ricknoboa137/OE_NPK_IoT_sensor/tests/2026-10-27_good_soil/readings.csv

timestamp | humidity | temperature | PH | N | P | K
1793103829 | 27.3 | 18.7 | 6.3 | 1.0 | 48.0 | 41.0
1793103834 | 33.0 | 18.7 | 6.4 | 3.0 | 53.0 | 45.0
1793103839 | 31.7 | 18.8 | 6.4 | 7.0 | 63.0 | 55.0
1793103844 | 31.0 | 18.8 | 6.5 | 7.0 | 62.0 | 54.0
1793103849 | 31.6 | 18.8 | 6.4 | 7.0 | 62.0 | 54.0
1793103854 | 35.0 | 18.8 | 6.4 | 7.0 | 62.0 | 55.0
1793103859 | 28.0 | 18.9 | 6.4 | 7.0 | 63.0 | 55.0
1793103864 | 32.7 | 18.9 | 6.4 | 7.0 | 62.0 | 55.0
1793103869 | 28.2 | 18.9 | 6.4 | 7.0 | 62.0 | 55.0
1793103874 | 33.2 | 18.9 | 6.5 | 7.0 | 63.0 | 56.0
1793103879 | 28.1 | 18.9 | 6.5 | 7.0 | 64.0 | 56.0
1793103884 | 27.8 | 19.0 | 6.5 | 8.0 | 64.0 | 57.0
1793103889 | 27.7 | 19.0 | 6.5 | 8.0 | 65.0 | 57.0
1793103894 | 28.0 | 19.0 | 6.5 | 9.0 | 68.0 | 60.0
1793103899 | 32.8 | 19.0 | 6.5 | 12.0 | 75.0 | 67.0
1793103904 | 32.7 | 19.0 | 6.5 | 11.0 | 72.0 | 64.0
1793103909 | 33.4 | 19.0 | 6.5 | 10.0 | 70.0 | 63.0
1793103914 | 33.0 | 19.0 | 6.5 | 10.0 | 71.0 | 63.0
1793103919 | 32.1 | 19.0 | 6.5 | 11.0 | 71.0 | 64.0
1793103924 | 29.0 | 19.1 | 6.5 | 11.0 | 71.0 | 64.0
1793103929 | 28.2 | 19.0 | 6.5 | 11.0 | 71.0 | 64.0
1793103934 | 32.1 | 19.1 | 6.5 | 11.0 | 72.0 | 64.0
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
