ricknoboa137/OE_NPK_IoT_sensor/tests/2026-10-25_weak_soil/readings.csv

timestamp | humidity | temperature | PH | N | P | K
1792950630 | 29.4 | 17.5 | 7.6 | 2.0 | 52.0 | 44.0
1792950635 | 28.0 | 17.5 | 7.5 | 6.0 | 61.0 | 53.0
1792950640 | 28.0 | 17.5 | 7.4 | 7.0 | 63.0 | 55.0
1792950645 | 32.6 | 17.6 | 7.2 | 8.0 | 64.0 | 57.0
1792950650 | 27.4 | 17.7 | 7.0 | 8.0 | 65.0 | 58.0
1792950655 | 30.4 | 17.9 | 6.9 | 8.0 | 66.0 | 59.0
1792950660 | 29.3 | 18.0 | 6.8 | 9.0 | 68.0 | 60.0
1792950665 | 27.6 | 18.1 | 6.7 | 9.0 | 68.0 | 61.0
1792950670 | 27.7 | 18.2 | 6.6 | 10.0 | 69.0 | 62.0
1792950675 | 29.8 | 18.3 | 6.6 | 10.0 | 70.0 | 63.0
1792950680 | 29.8 | 18.5 | 6.5 | 11.0 | 71.0 | 64.0
1792950685 | 28.1 | 18.6 | 6.5 | 11.0 | 72.0 | 64.0
1792950690 | 31.6 | 18.7 | 6.4 | 11.0 | 73.0 | 65.0
1792950695 | 29.3 | 18.8 | 6.4 | 12.0 | 74.0 | 66.0
1792950700 | 27.4 | 18.8 | 6.3 | 12.0 | 74.0 | 67.0
1792950705 | 27.7 | 19.0 | 6.3 | 12.0 | 75.0 | 67.0
1792950710 | 27.6 | 19.0 | 6.3 | 13.0 | 76.0 | 68.0
1792950715 | 27.9 | 19.1 | 6.2 | 13.0 | 76.0 | 69.0
1792950720 | 27.4 | 19.2 | 6.2 | 13.0 | 76.0 | 69.0
1792950725 | 27.9 | 19.3 | 6.2 | 13.0 | 77.0 | 69.0
1792950730 | 29.9 | 19.3 | 6.2 | 13.0 | 77.0 | 70.0
1792950735 | 27.8 | 19.4 | 6.1 | 13.0 | 78.0 | 70.0
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
