ricknoboa137/OE_NPK_IoT_sensor/tests/2026-10-25_weak_soil/weak_soil_test.png

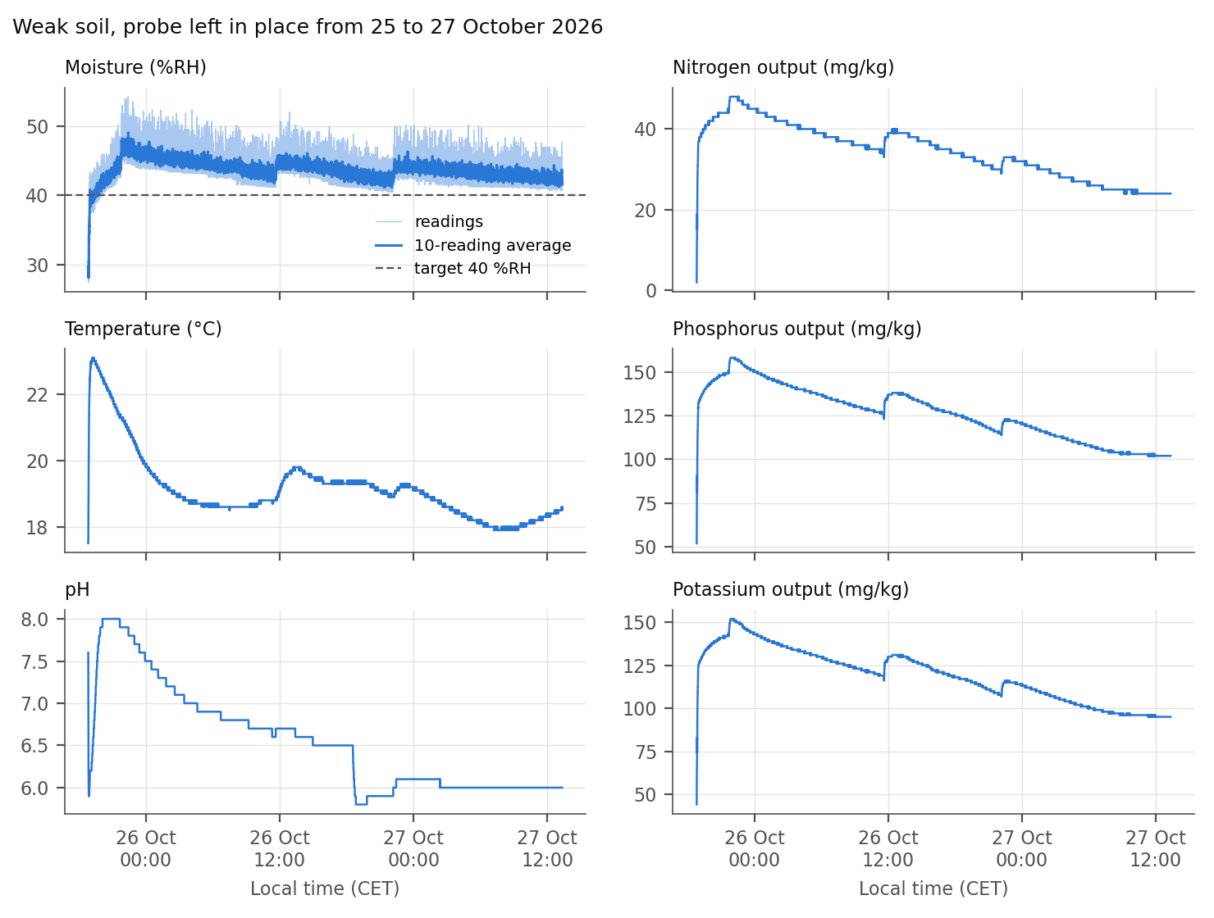
tests/2026-10-25_weak_soil/weak_soil_test.png
