ricknoboa137/OE_NPK_IoT_sensor/tests/2026-10-27_good_soil/good_soil_test.png

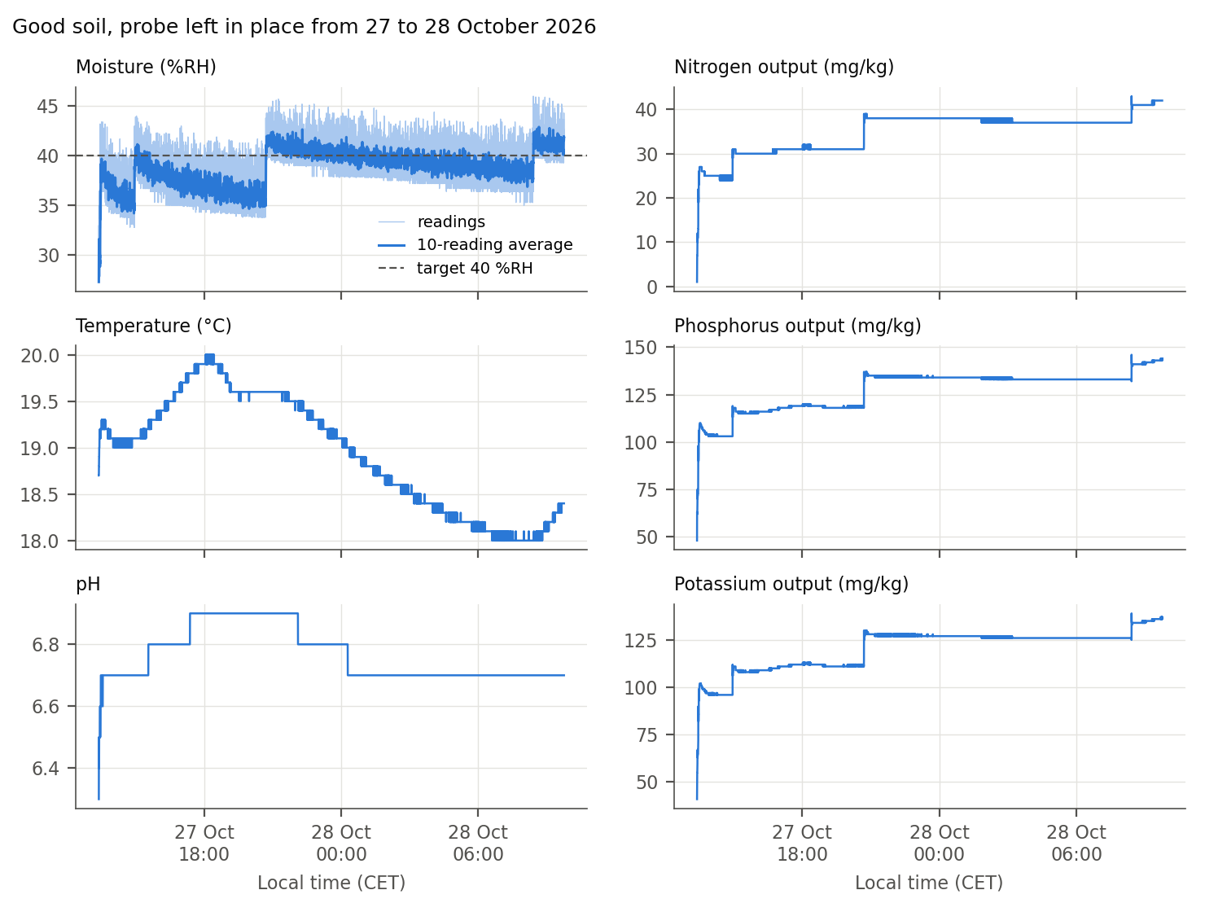
tests/2026-10-27_good_soil/good_soil_test.png
