ricknoboa137/OE_NPK_IoT_sensor/tests/2026-10_two_soil_calibration/two_soil_comparison.png

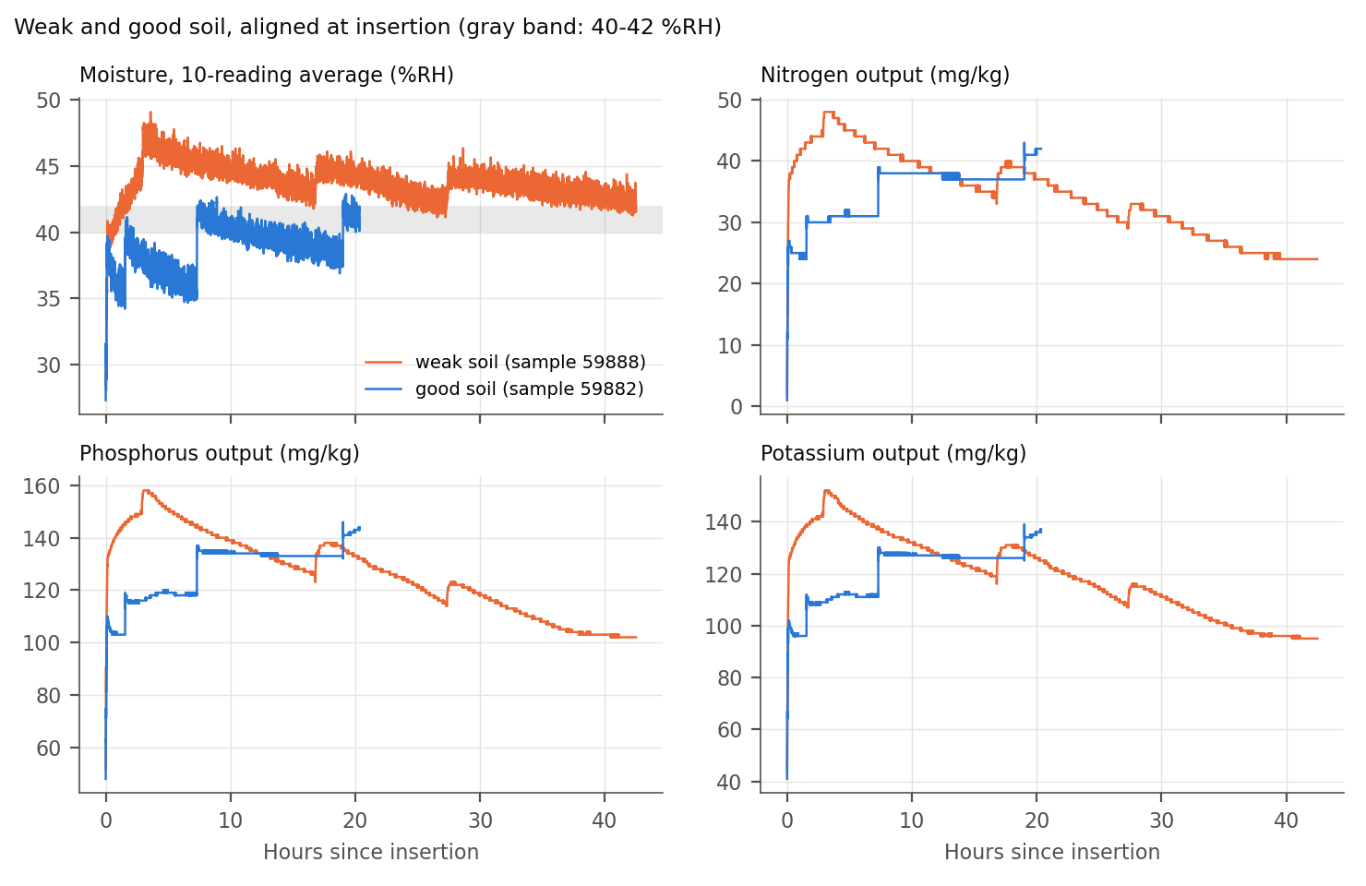
tests/2026-10_two_soil_calibration/two_soil_comparison.png
