ricknoboa137/OE_NPK_IoT_sensor/firmware/SoilNode/NpkNet.h

/*
 * NpkNet.h - WiFi provisioning and the MQTT link.
 *
 * Deliberately NOT called NetworkManager: arduino-esp32 3.x declares a class
 * of that name in libraries/Network/src/NetworkManager.h, which WiFi.h pulls
 * in transitively, and the two collide.
 *
 * Differences from the original sketch that matter in the field:
 *
 *  - The broker address and port entered in the captive portal are written to
 *    NVS and reloaded at boot. Previously they were captured into RAM after
 *    setServer() had already been called with the compile-time defaults, so
 *    the portal fields never took effect.
 *  - A broker outage no longer erases the WiFi credentials. The original
 *    reconnect() called wm.resetSettings() after five failed MQTT attempts,
 *    which meant a broker reboot could strand the node in AP mode.
 *  - Reconnection is non-blocking with backoff, so sampling continues while
 *    the broker is unreachable.
 */
#ifndef NPK_NET_H
#define NPK_NET_H

#include <Arduino.h>

class NpkNet {
 public:
  typedef void (*MessageHandler)(char* topic, uint8_t* payload, unsigned int length);

  // forcePortal opens the configuration portal even when stored credentials
  // would have connected, so the broker fields can be changed in the field.
  bool begin(MessageHandler handler, bool forcePortal = false);

  // Pumps the MQTT client and retries the connection when it is down.
  // Never blocks for longer than one connection attempt.
  void loop();

  bool connected();
  bool publish(const char* topic, const char* payload, bool retain = false);

  const char* host() const { return host_; }
  uint16_t    port() const { return port_; }
  const char* clientId() const { return clientId_; }

  const char* user() const { return user_; }
  bool hasAuth() const { return user_[0] != 0; }

  // Store a new broker and drop the current connection so loop() picks it up.
  bool setBroker(const char* host, uint16_t port);

  // Broker credentials. Pass empty strings for an anonymous broker.
  bool setAuth(const char* user, const char* pass);

  void startPortal();   // open the config portal on demand
  void forgetWiFi();    // clear stored credentials, then reboot

  void printStatus(Print& out);

 private:
  bool connectBroker();
  void loadSettings();

  char     host_[40] = { 0 };
  uint16_t port_ = 1883;
  char     user_[33] = { 0 };
  char     pass_[65] = { 0 };
  char     clientId_[24] = { 0 };
  uint32_t nextAttempt_ = 0;
  uint32_t backoff_ = 0;
};

#endif // NPK_NET_H
