ricknoboa137/OE_NPK_IoT_sensor/(commit log)

2026-04-01 Update IoT_NPK_sensor.ino
    Updated NPK sensor Code, JSon structure added
2026-08-23 Restructure firmware into modules and add per-channel calibration
    The sketch was a single file in which the Modbus layer, the WiFi
    provisioning, the MQTT client and the payload assembly were interleaved.
    Split it into modules and fix the defects that showed up while doing so.
    The original is kept at firmware/original/IoT_NPK_sensor.ino.
    Structure (firmware/NPK_Sensor/):
    Config.h all tunables
    Channels.* the seven quantities, units and scale factors
    SoilSensor.* Modbus RTU master: CRC, turnaround, retries, map
    Calibration.* A and B per channel, persisted in NVS
    NetworkManager.* WiFiManager provisioning and the MQTT link
    CommandHandler.* console shared by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
    [Calibration.h, CommandHandler.cpp, IoT_NPK_sensor.ino, JsonCompat.h, NPK_Sensor.ino, NetworkManager.cpp, NetworkManager.h]
2026-08-23 Rename NetworkManager to NetLink to fix a clash with the ESP32 core
    arduino-esp32 3.x ships its own NetworkManager class in
    libraries/Network/src/NetworkManager.h, which WiFi.h pulls in
    transitively, so building against core 3.2.1 failed with:
    error: redefinition of 'class NetworkManager'
    Both the class and the header basename collided. Renamed to NetLink and
    noted in the header why, so it does not get renamed back.
    Checked the rest of the sketch against the 3.2.1 tree while here: no other
    header basename or type name in this firmware collides with anything the
    core declares.
    [CommandHandler.cpp, NPK_Sensor.ino, NetLink.cpp, NetLink.h]
2026-08-23 moved original code to subfolder for arduino copiler
2026-08-23 Rebuild the firmware as SoilNode with an Npk prefix on every name
    Replaces firmware/NPK_Sensor/ with firmware/SoilNode/. Same design and
    same verified logic; new folder, new filenames, new type names.
    Two reasons for the move:
    1. arduino-esp32 3.x declares class NetworkManager in
    libraries/Network/src/NetworkManager.h, which WiFi.h pulls in. The
    previous revision collided with it. Renaming one class fixed that
    instance but left the general hazard. Every file and type is now
    prefixed Npk, checked against the 3.2.1 tree: nothing collides.
    2. Arduino leaves stale copies of renamed sketch files in its build
    folder and keeps compiling them (arduino-cli#1699), so the earlier
    N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
    [NpkCal.cpp, NpkCal.h, NpkConfig.h, NpkConsole.cpp, NpkConsole.h, NpkJson.h, NpkNet.cpp, NpkNet.h]
2026-08-23 Add MQTT credentials to the portal and a way to reopen it
    Reported: the configuration AP never appears. That is autoConnect() doing
    what it does - it only raises the AP when the stored credentials fail, and
    WiFi credentials saved by the previous sketch live in the NVS partition and
    survive reflashing, so the node joins silently. Working as intended, but
    with no way back in once it does. Three routes added:
    - hold BOOT during the first three seconds of boot (NPK_PORTAL_BTN_*).
    Sampled after startup, not through reset, since GPIO0 low at reset means
    download mode.
    - "wifi portal" on the console, without dropping the WiFi connection.
    - "wifi reset", unchanged.
    The portal was also missing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
    [NpkConfig.h, NpkConsole.cpp, NpkNet.cpp, NpkNet.h, NpkSensor.cpp, SoilNode.ino]
2026-08-23 Default to the contiguous register map and reject impossible readings
    Reported values were 152.4 %RH, 151.7 degC and 4090 mg/kg N with ok:true -
    every CRC valid, every number wrong.
    This probe is the contiguous-block variant, not the one the manual
    describes. Evidence, from the 83,883 rows the original firmware logged into
    DB_01.db reading 0x0000-0x0006 with everything scaled by 0.1:
    humidity 0 - 75.9 % (range 0-100)
    temperature 17.7 - 29.9 degC
    pH 3.9 - 9.0 (datasheet spec is 3-9 pH)
    N/P/K 0 - 44.6 mg/kg (range 0-1999)
    All physically sensible, and the pH range in particular is not something a
    wrong scale lands on by accident. The bad rea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
    [NpkConfig.h, NpkConsole.cpp, NpkSensor.cpp, NpkSensor.h]
2026-08-23 Retarget the firmware at the VMS-3001-TR, the sensor actually in use
    The probe is a VMS-3001-TR-*-N01 (Weimengshi five-pin soil transmitter), not
    the JXBS-3001 this project started from. Its manual is included, and unlike
    the JXBS one it is internally consistent - both example CRCs verify and every
    worked example decodes to the value it claims.
    Register map, manual section 5.3, confirmed by the worked example in 5.4:
    0x0000 moisture value x10 -> /10
    0x0001 temperature value x10 -> /10, signed
    0x0002 conductivity whole us/cm, NOT scaled
    0x0003 pH value x10 -> /10
    0x0007 salinity, 0x0008 TDS (documented, not read)
    0x0050-0x0053 on-sensor calibration offs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
2026-08-23 Retarget at the CWT NPK 5-pin probe and fix the N/P/K scaling
    The correct manual is "NPK type (5Pin probe) manual V1.4" from Shenzhen
    ComWinTop, now included in firmware/SoilNode/. The two earlier manuals this
    project was worked against - JXBS-3001 and VMS-3001-TR - described different
    sensors and are discarded.
    Unlike either of those, this manual is trustworthy: all nine of its example
    frames CRC-check correctly and every worked example decodes to the value it
    claims.
    Register map (manual page 3), function 0x03:
    0x0000 humidity 0.1 %RH /10
    0x0001 temperature 0.1 degC /10, signed
    0x0002 conductivity 1 us/cm /1
    0x0003 pH 0.1 /10
    0x0004 nitrogen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
    [NpkConfig.h, NpkConsole.cpp, NpkConsole.h, NpkSensor.cpp, NpkSensor.h]
2026-08-23 Publish conductivity again, documenting that this unit always reads 0
    Register 0x0002 is slot 2 of the block already being read, so decoding and
    publishing it costs nothing. This probe reports a constant 0 because it does
    not measure conductivity - the register answers with a valid CRC, so zero is
    the correct reading rather than a fault.
    Zero is inside the 0-20000 us/cm range, so the range check passes it and "ok"
    stays true. Documented in both READMEs and in the header comments, since a
    permanently flat channel otherwise looks like a bug.
    NPK_ENABLE_CONDUCTIVITY still drops it from the payload if the constant is
    not wanted; verified that the enum, channel table and slot map stay
    consisten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
    [NpkConfig.h, NpkSensor.h]
2026-08-23 Validate calibration coefficients at every boundary they cross
    Asked how the A and B values are validated. Auditing it turned up three
    gaps, all now closed.
    1. Nothing validated the factors read back from the probe. readFloat()
    reinterpreted two raw registers as a float and returned it, so an
    unimplemented or never-written register decoded to NaN, an infinity or a
    denormal and "sensor" printed it as a gain. It now rejects non-finite and
    denormal values with a reason.
    2. The range check ran on the raw reading only, before calibration. A
    mistyped coefficient turned a valid 46.4 %RH into 46400 and published it
    with ok:true. The calibrated result is now checked against the sa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
2026-08-23 Read back the three registers that have documented factory defaults
    The "sensor" command read the offset registers and the N/P/K factor floats
    but skipped 0x0022-0x0024, which are the only calibration registers the
    manual gives factory values for: conductivity factor 0, salinity factor 55,
    TDS factor 50.
    Those are worth having for two reasons. They answer "what did this unit ship
    with", which the other registers cannot since the manual documents no
    defaults for them. And they are a free end-to-end check - if 0x0023 reads 55
    and 0x0024 reads 50, addressing, framing and decoding are all confirmed
    against known-good values, which is useful given nothing on the write path
    has been exercised aga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
    [NpkConsole.cpp]
2026-08-23 Fix two string literals broken by a raw newline, and add a checker
    Both sites lost their escape and ended up with a real newline inside the
    literal:
    out.printf("error: %s
    ", why);
    That is my error, introduced while editing, and it made the previous commit
    fail to compile. Repaired to \r\n, matching every other format string here.
    Adds test/check_sources.py so this cannot ship again. It catches, without a
    toolchain: unterminated string literals, unbalanced brackets, printf
    argument counts against the format string, unresolved local includes,
    methods declared but never defined, and NUL bytes. Confirmed against the
    real fault - reintroducing the broken literal makes it report
    NpkConsole.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
    [NpkConsole.cpp]
2026-08-23 Solve the probe's own A and B from standards and write them back
    The probe already holds a gain and an offset per nutrient. Reading and
    writing them individually was supported; what was missing is the step in
    between - working out what they should be.
    "sensor cal <n|p|k> low <ref>" then "... high <ref>" reads the pair the
    probe currently holds, measures against two standards, and composes a
    correction on top rather than overwriting blindly:
    g = (r2 - r1) / (y2 - y1)
    A' = A * g
    B' = r1 - g * (y1 - B)
    The probe's internal value never appears in that, so its internal scaling
    does not need to be known, and the result is identical whatever the starting
    coefficients were - verified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
    [NpkConsole.cpp]
2026-08-23 Size the MQTT reply buffer for the sensor dump, and never truncate silently
    Checking how to invoke the coefficient read turned up that its own reply does
    not fit. The "sensor" dump is around 900 bytes once every register has been
    read back, against a 704-byte reply buffer, and NpkBufferPrint discarded the
    overflow without a word - so over MQTT the answer arrived cut in half looking
    like the whole thing.
    - NPK_MQTT_BUFFER 768 -> 1280, giving a 1216-byte reply allowance.
    - NpkBufferPrint tracks overflow, and handleMqtt publishes an explicit
    truncation notice after the partial reply instead of pretending it is
    complete. The serial copy was never truncated and still is not.
    - The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
    [NpkConfig.h, NpkConsole.cpp, NpkConsole.h, SoilNode.ino]
2026-08-23 Document that sensor commands do work over MQTT, both forms
    The README claimed they had no JSON form. Any unrecognised cmd is passed
    through to the parser verbatim, so {"cmd":"sensor cal n low 50"} reaches the
    same place as the plain-text line. Both are now shown.
2026-08-24 Chunk long MQTT replies, add cal export/json, and a filtered scan
    Console replies no longer truncate over MQTT, and the calibration held in NVS
    can now be backed up and read by machine.
    Replies (task 1). Raising the buffer cannot fix this: "scan" output is
    unbounded and this probe answers at all 65536 addresses, so a full sweep is
    over half a megabyte. Output now streams through NpkChunkedPrint, published
    across as many NPKreply messages as it takes with constant RAM. Splits happen
    only at line boundaries, so no register line is ever cut. Every part except
    the last ends with a line reading exactly "[continues]"; a reply that fits in
    one message carries no marker, so short replies are byte-i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
    [NpkConsole.cpp, NpkConsole.h, NpkSensor.cpp, NpkSensor.h]
2026-09-05 Add Node-RED flows, original database, and tools
2026-09-06 Warn on the two ways a two-soil NPK fit goes wrong silently
    Calibrating N, P and K today from two lab-assayed soils. Both failure modes
    here are invisible after the fact, because a two-point fit passes through
    both points exactly whichever values it was given.
    Negative gain. If the two references are entered against the wrong samples
    the fit is still perfect, just backwards. "cal high" now warns, matching what
    "sensor cal" and solve_firmware_cal.js already did - the firmware-side path
    was the one being used today and was the one without the warning.
    Negative B. B is what a channel reports when the probe reads zero. If it is
    negative, a bottomed-out reading becomes a negative concentration,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
    [NpkConsole.cpp]
2026-09-06 Pool captures by label prefix and report placement uncertainty
    Calibrating N/P/K today from two lab-assayed soils. The plan was 20 readings
    per soil, averaged. Twenty readings from one insertion measure sensor noise,
    which on this probe is nearly zero - the last captures gave N=45 seven times
    with no variation at all. What they do not measure is the thing that actually
    moves the answer: where the pins happen to sit in a heterogeneous sample.
    So the solver now pools every capture whose label starts with the given
    prefix, oldest first - "GOOD" matches GOOD, GOOD-1, "GOOD spot 3". Each run
    of capture_sample.js is one insertion, and the scatter BETWEEN insertions is
    the uncertainty that matters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
2026-09-06 Add --quick capture mode, skipping the register dump
    One run of capture_sample.js is one insertion. When calibrating, the register
    windows are dead weight - they exist for the constant-hunting experiment,
    which REGISTER_FINDINGS closed. Skipping them takes a capture from about 48
    seconds to 15, which matters across dozens of insertions.
    --seconds=N sets the collection window. Flags are filtered out before the
    positional label and note, so existing invocations are unaffected.
2026-09-07 Add the analysis behind the manuscript's characterisation section
    paper_analysis.py reproduces every statistic quoted in the new section from
    DB_01.db and the SZ-24 laboratory database: the fixed relations between the
    three nutrient outputs, the nitrogen clamp, the moisture sensitivity, the
    laboratory correlations and the principal component split.
    solve_paper_cal.py solves the two-soil calibration from
    SoilSamplesCalibrationTest.xlsx matched against the laboratory values on the
    Mintakod sample code. It reports the fit and refuses to present it as usable:
    the instrument ranks the two soils opposite to the laboratory for P and K, the
    two soils differ by only 1.6 mg/kg in nitrate-nitrogen so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
2026-09-07 Use all forty calibration readings, and archive the manuscript scripts
    One potassium value was recorded as 9189 beside a phosphorus value of 196.
    The device's own internal relation, K = 1.0079*P - 8.07, predicts 189.5, so
    this is a leading-digit slip for 189. It is now corrected rather than
    discarded, so all forty readings are used and the design is a balanced twenty
    per soil. Set CORRECT_TYPO = False to drop the row instead; doing so moves the
    fitted gains by under two percent and changes none of the conclusions.
    Revised figures: bad soil N 73.30 +/- 11.74, P 216.05 +/- 27.21,
    K 209.75 +/- 27.33, moisture 43.0 +/- 1.7 %RH.
    The conclusions are unaffected. Phosphorus and potassium are still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
2026-09-07 Move the manuscript scripts to the paper repository
    These four scripts analyse the logged readings for the Agriculture-4351955
    manuscript and read that repository's laboratory database and calibration
    workbook. They belong with the paper, not with the firmware, and now live in
    its analysis/ directory.
    Nothing the firmware needs is affected.
2026-09-16 Add the manuscript analysis scripts from the paper repository
    They read DB_01.db from this repository and the manuscript, laboratory
    database and calibration workbook from the paper repository, whose
    location is set with PAPER_DIR. The manuscript file name is resolved at
    run time, since it is renamed periodically in Overleaf.
2026-10-10 Add the satellite case-study and insertion analyses behind the manuscript
    ndmi_station_analysis.py compares field-mean Sentinel-2 NDMI with the
    Csolnok station soil moisture and measures the within-field spread.
    insertion_analysis.py measures settling after insertion from the 5 s log
    and the nitrogen-moisture relation across insertions in one soil. This
    replaces the earlier moisture-sensitivity figure, which had been fitted
    to a window of the insertion campaign mislabelled as an irrigation
    session. The audit and the structure check follow the revised text.
2026-10-10 Make the manuscript figures reproducible from versioned data alone
    The scripts now read the sensor log, the NDMI series and the station
    record from the paper repository's data folder instead of local files.
    Adds the script for the field figure, the two scripts that record how
    the data files were derived, and a README with the commands.
2026-10-10 Add the script that marks the current round's changes in a second color
2026-10-10 Add the database and the instructions to replicate the prototype
    database/ holds the schema, the readings logged from January to
    September 2026 and a script that builds the SQLite file from them. The
    README now gives the connections, taken from NpkConfig.h and the probe
    manual, and the steps for the firmware, the broker, the Node-RED flow
    and the database. The manuscript scripts read the log from here.
2026-10-26 Add the weak-soil test of 25 October and update the public log
    database/sensor_log.csv.gz now holds every reading to 26 October 2026;
    the manuscript's results, which use readings up to 9 September, are
    unchanged. tests/2026-10-25_weak_soil keeps the readings, the script
    and the figure of the new test.
2026-10-27 Record the move to the good soil on 27 October
    The weak-soil test ends at its last reading, 13:20:04 local time. The
    good-soil test starts with the insertion at 13:23:04; its folder holds
    the record of the change, the plotting script and the first readings.
2026-10-28 Close the good-soil test and add the two-soil calibration of October
    The good-soil test ends at 09:45:02 local time on 28 October, when the
    laptop was disconnected from the flow. calibrate.py solves A and B from
    the two tests in three reading windows; the coefficients change sign
    with the window, so none are adopted. The public log is updated.
2026-10-30 Base the manuscript audit on the October test
    record_analysis.py gives the October relations, moisture steps and
    settling; the audit now checks the manuscript against them and against
    the calibration results. The READMEs state which window the manuscript
    reports and record the window it leaves out.
